yoyooxo/20261030_3D/card_reader_nicenano/讀卡機_整理.md

# 讀卡機（nice!nano＋健保卡卡座）整理

更新：2026-11-12

## 1. 目標

把老師麵包板上的讀卡機原型，原樣搬到洞洞板上，不用麵包板。

- 只用 **nice!nano v2（nRF52840）**，不用 BlackPill、DMC2038LVT、R1。
- 卡座貼在洞洞板背面，插卡口在上。
- nice!nano 的 USB-C 朝下，在插卡口對面。
- **線全部在正面，用 OK 線手焊。**
- 電池另外用雙面膠黏。

## 2. 手上的資料

| 資料 | 位置 | 內容 |
|---|---|---|
| 老師線路圖 | `老師給的東西\261103_nrf_card.pdf` | nice!nano 接 ISO 7816 卡座，接線照這份 |
| 卡座腳位（紅字） | 老師線路圖紙本的手寫標註（照片 742400 / 742404） | 插卡口那排 C5–C8、對面那排 C1–C4 |
| 卡座照片 | `S__13606916_0.jpg`、`S__13606917_0.jpg` | 卡座正反面 |
| 麵包板原型 | `742396.jpg`、`742400.jpg`、`742404.jpg` | 老師接好的原型 |
| 卡座焊在洞洞板 | `742616.jpg`、`S__14311426.jpg` | 8 支腳直接焊進洞洞板 |
| 裝盒成品 | `742949.jpg` | 3D 列印盒子裡的最終擺法 |
| 實測 | 你量的 | 卡座長邊 62 mm |

照片都在 `C:\Users\jkgen\Documents\實驗室資料夾\硬體\IC卡設計\老師給的東西\`。

## 3. 線路（照老師 261103_nrf_card.pdf）

| 卡座 J1 | 接到 nice!nano | 說明 |
|---|---|---|
| C1 VCC | VCC（腳 21） | +3V3_CARD，可用 P0.13 開關，所以可以斷電重開卡片 |
| C2 RST | P0.24（腳 8） | RST |
| C3 CLK | P0.17（腳 5） | CLK |
| C5 GND | GND（腳 3、4 併接） | 卡片 GND |
| C7 I/O | P0.20（腳 6）＋P0.22（腳 7） | 兩腳併接 |
| SW1 DET | P1.00（腳 9） | 插卡偵測（選配） |
| SW2 DET_G | GND | 偵測開關接地（選配） |
| C4、C6、C8 | 不接 | 腳還是焊進洞，用來固定卡座 |

其他：

- C10 0.1 µF：跨在 VCC 和 GND 之間。
- 電池＋：接 RAW（腳 24），電池－接 GND（腳 23）。
- P0.08 標「UART_TX」、P1.06 標「U3_D1」，另一端沒接東西，不焊。

## 4. 照片上確定的事

1. **卡座 8 支腳：** 分兩排，每排 4 支連在一起（間距 2.54 mm），直接焊進洞洞板。
2. **兩排間距：** 相隔 16 個孔，約 40 mm，所以卡座約 62 × 40 mm。
3. **洞洞板：** 老師用的約 12 × 22 孔（30.5 × 55.9 mm）。卡座左緣比板子多出約 4 mm。
4. **nice!nano：** 平貼在板子左下，USB-C 朝下，轉 180°。
   - 左排（c1，下→上）：RAW、GND、RST、VCC、P0.31…
   - 右排（c7，下→上）：P0.06、P0.08、GND、GND、P0.17、P0.20、P0.22、P0.24、P1.00…
5. **電池：** 在 nice!nano 右邊、卡座下方，約 13 × 23 mm。
6. **盒子：** 3D 列印、接近正方形、有蓋，下側開孔給 USB-C。
7. **燒錄排針：** 盒子裡有一個 3 pin 彎排針插在卡座上，應該是燒錄用。麵包板原型則是 6 pin（TX、RX、SWCLK、SWDIO、2.8V、GND）。

## 5. 目前的 Layout：v6

檔案：`讀卡機Layout_v6.png`（另有 `.svg`、`gen_layout_card6.py`）

### 擺法

- **洞洞板：** 12 × 22 孔（30.5 × 55.9 mm），直放，上緣對齊插卡口。
- **卡座：** 在板子背面。
- **卡座 8 個洞：**

| 位置 | c9 | c10 | c11 | c12 |
|---|---|---|---|---|
| 插卡口那排（第 22 列） | C8 | C7 | C6 | C5 |
| 對面那排（第 6 列） | C4 | C3 | C2 | C1 |

- **nice!nano：** 腳在 c1、c7，第 1–12 列，USB-C 從板子下緣凸出。
- **C10：** c11、c12 第 4 列。
- **電池：** 在 nice!nano 右邊下方（c8–c13、第 1–5 列），最後用雙面膠黏。
- **J2：** 燒錄 3 pin，位置先畫在板子右邊的卡座上，還沒接線。

### 接線表（全部在正面，OK 線）

| 線 | 從 | 到 | 用途 |
|---|---|---|---|
| K1 | VCC 腳21 (c1,r4) | J1 C1 VCC (c12,r6) | +3V3_CARD，經過 C10 |
| K2 | GND 腳4 (c7,r4) | J1 C5 GND (c12,r22) | 卡片 GND，跨過 nice!nano |
| K3 | P0.24 腳8 (c7,r8) | J1 C2 RST (c11,r6) | RST |
| K4 | P0.17 腳5 (c7,r5) | J1 C3 CLK (c10,r6) | CLK |
| K5 | P0.20 腳6 (c7,r6) | J1 C7 I/O (c10,r22) | I/O，跨過 nice!nano |
| K6 | P0.20 腳6 (c7,r6) | P0.22 腳7 (c7,r7) | I/O 兩腳併接 |
| K7 | GND 腳3 (c7,r3) | GND 腳4 (c7,r4) | GND 兩腳併接 |
| K10 | GND 腳4 (c7,r4) | C10 左腳 (c11,r4) | C10 接地 |
| K8 | P1.00 腳9 (c7,r9) | J1 SW1 DET | 插卡偵測（選配） |
| K9 | J1 SW2 DET_G | C10 左腳 GND (c11,r4) | 偵測開關接地（選配） |
| K11 | 電池 ＋ | RAW 腳24 (c1,r1) | VBAT |
| K12 | 電池 － | GND 腳23 (c1,r2) | 電池負極 |

孔位寫法：(c 欄, r 列)。c 從左到右 1–12，r 從下到上 1–22，正面俯視。

- K2、K5 會從 nice!nano 上方跨過；K1 會跨過 K4；K9 會跨過 K1。
- OK 線有絕緣，交叉沒關係。

### 組裝順序

1. 卡座 8 支腳焊進洞，nice!nano 固定好（背面剪平）。
2. 正面用 OK 線照接線表接。
3. 最後貼電池。

## 6. 還沒確定、要確認的

| 項目 | 目前做法 | 怎麼確認 |
|---|---|---|
| 插卡口在哪一排 | 照你說的放上面 | 實際插卡看一下 |
| 卡座寬度、腳的確切位置 | 照片估約 40 mm、兩排相隔 16 孔 | 用尺量卡座和兩排腳的距離 |
| 偵測開關 SW1/SW2 的腳在哪 | 先畫在板子右外側 | 看卡座實物 |
| J2 燒錄 3 pin 各接哪裡 | 先不接 | 問老師，或看盒裡那片板子的線 |
| 電池實際大小 | 約 13 × 23 mm（照片估） | 量電池 |
| 盒子內部尺寸 | 沒畫 | 量盒子，或跟老師要列印檔 |

## 7. Layout 版本紀錄

| 版本 | 檔案 | 重點 |
|---|---|---|
| v1 | `讀卡機Layout_v1.png` | 25 × 61 直放，nice!nano 在下；左右排 C 接點是假設的（之後證實相反） |
| demo v2 | `讀卡機Layout_demo_v2.png` | 板子橫放 |
| demo v3 | `讀卡機Layout_demo_v3.png` | 直放靠卡座右緣，USB-C 在插卡口對面 |
| v4 | `讀卡機Layout_v4.png` | 卡座 8 支腳都插洞，板子加寬到 13 欄 |
| v5 | `讀卡機Layout_v5.png` | 照老師盒裝版排法；兩排腳間距估成 13 孔（估錯） |
| **v6** | `讀卡機Layout_v6.png` | **目前版本**：照片重新數孔，12 × 22 孔、兩排腳相隔 16 孔 |

## 8. 跟 GitHub 的關係

- GitHub（`yoyooxo/20261030_3D`）目前是上一個專案的內容：61 × 53 洞洞板＋BlackPill＋DMC2038LVT，以及線路圖和舊 PCB。
- 讀卡機這套（`讀卡機_nicenano` 資料夾）**還沒推上 GitHub**。
