yoyooxo/20261030_3D/card_reader_nicenano/讀卡機Layout_v5.png

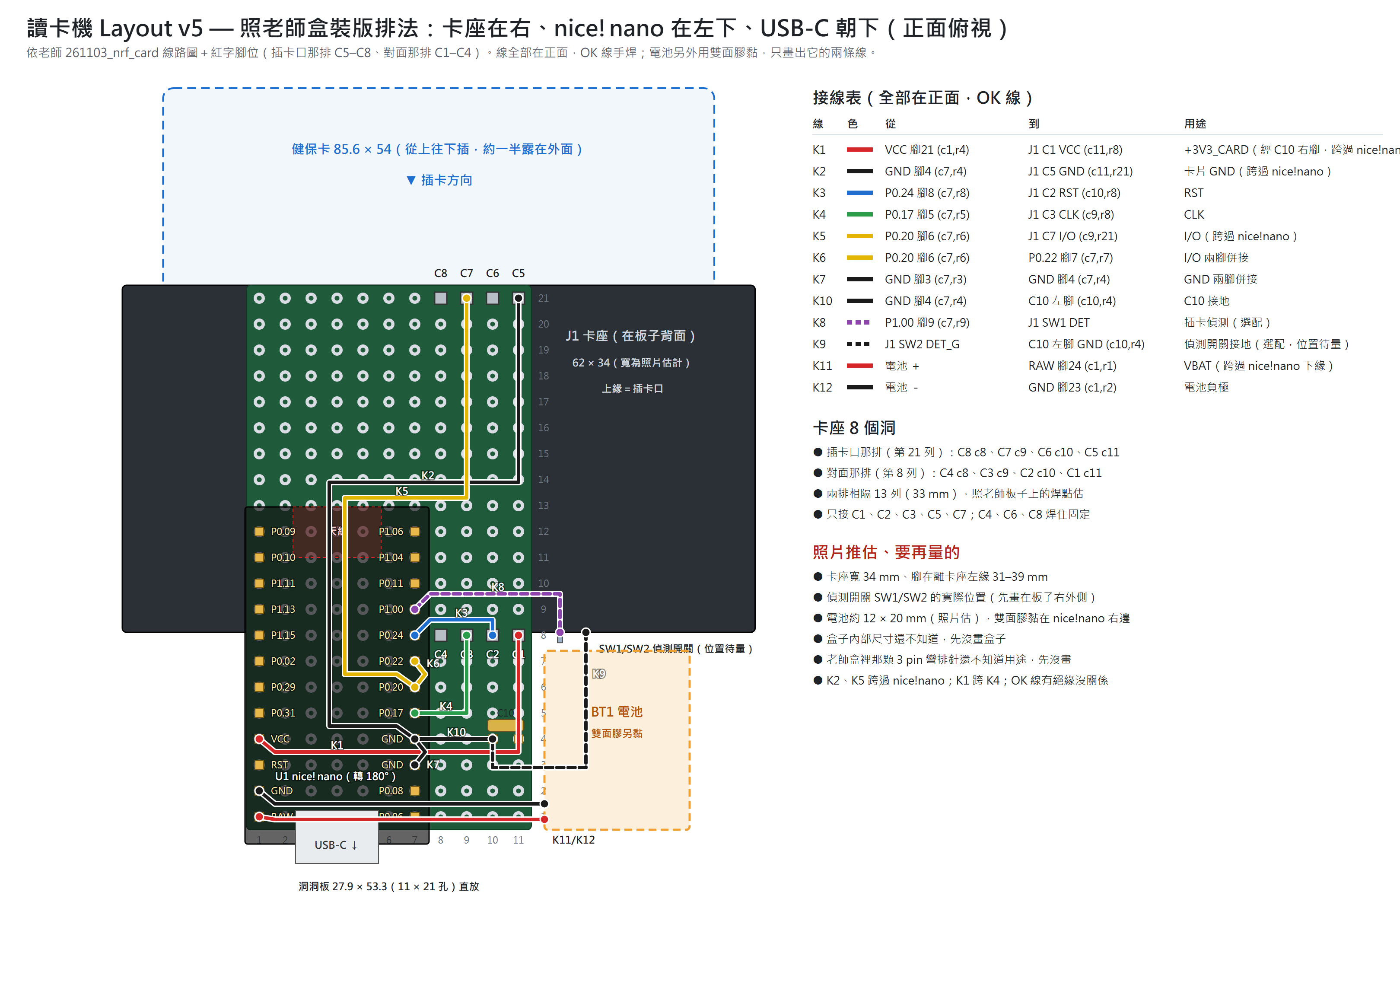
card_reader_nicenano/讀卡機Layout_v5.png
