yoyooxo/20261030_3D/pcb_flat/3d_side.png

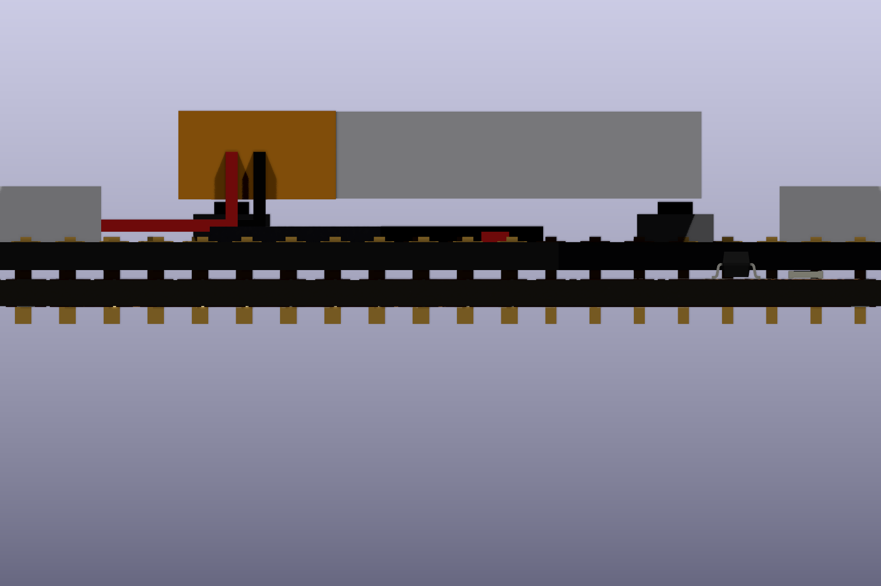
pcb_flat/3d_side.png
