yoyooxo/20261030_3D/pcb_flat/3d_top_iso.png

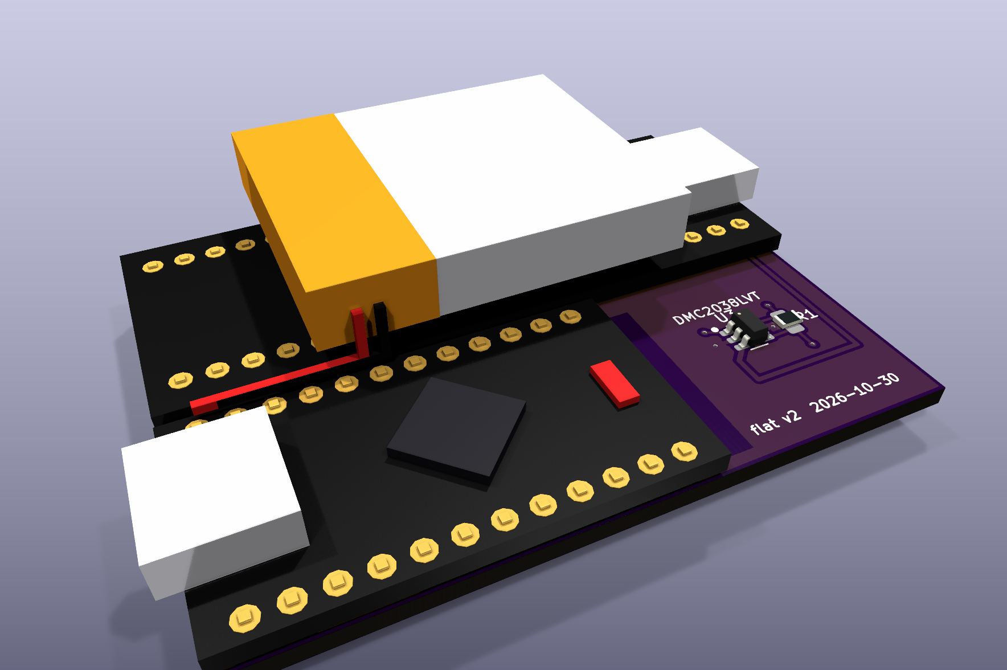
pcb_flat/3d_top_iso.png
