yoyooxo/20261030_3D/pcb_flat/dimensions.png

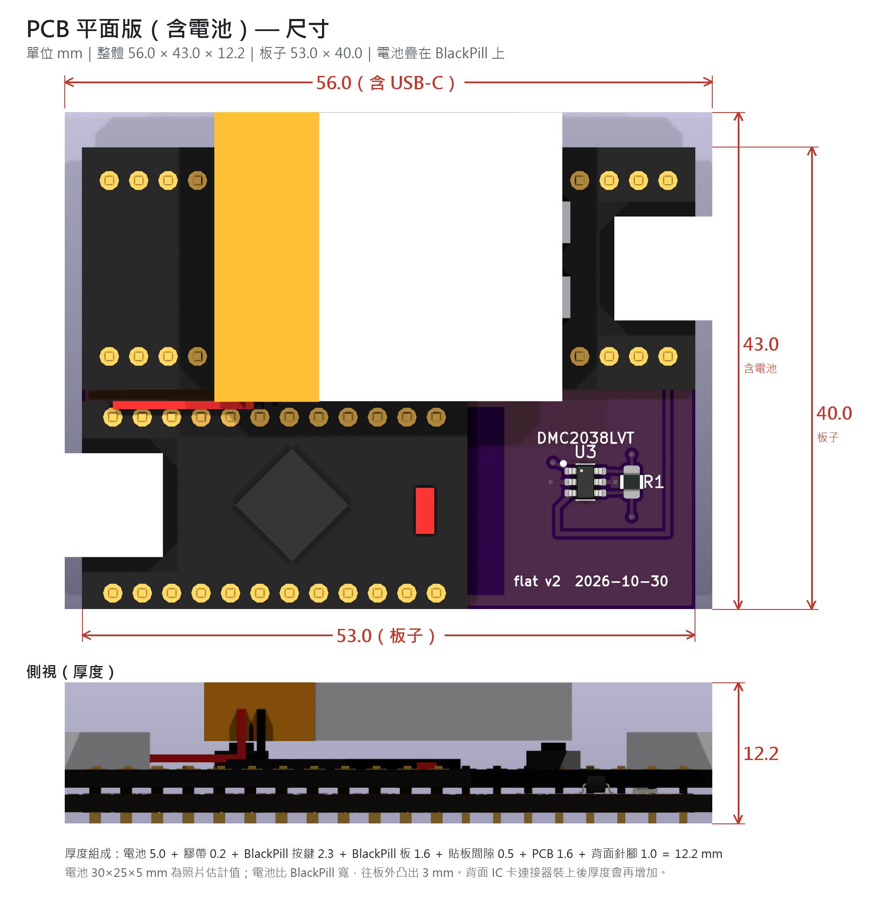
pcb_flat/dimensions.png
