yoyooxo/20261030_3D/pcb_flat/front_back.png

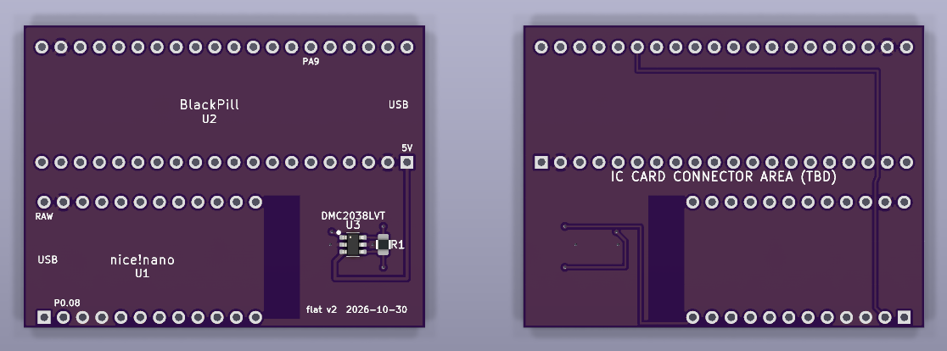
pcb_flat/front_back.png
