yoyooxo/20261030_3D/perfboard/perfboard_layout_61x53.png

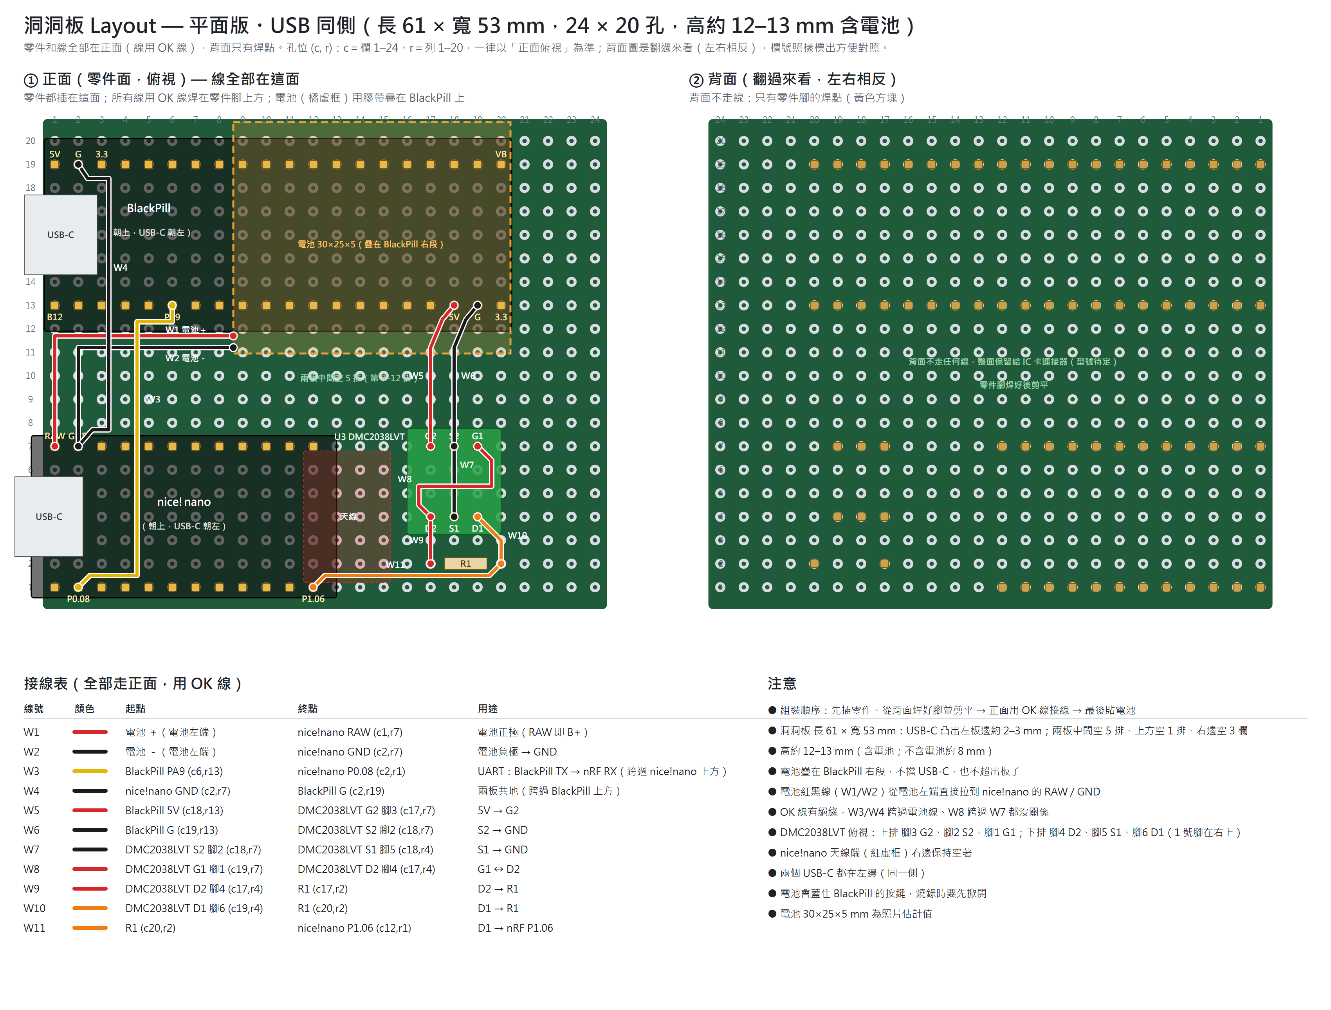
perfboard/perfboard_layout_61x53.png
