yoyooxo/20261030_3D/schematic/schematic_61x53.png

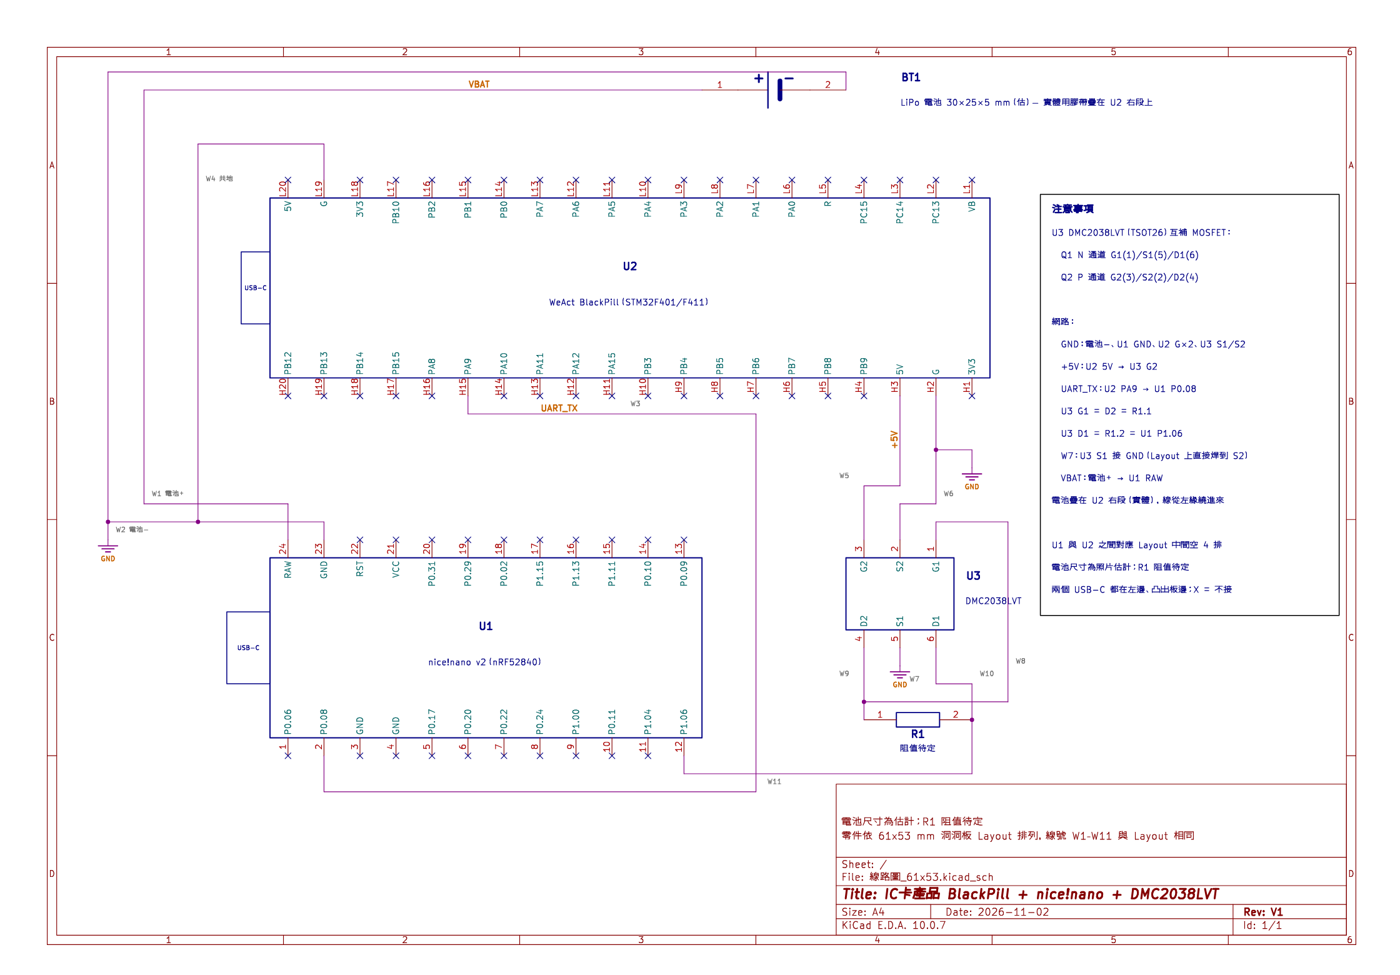
schematic/schematic_61x53.png
