yoyooxo/20261030_3D/schematic/schematic_61x53.pdf

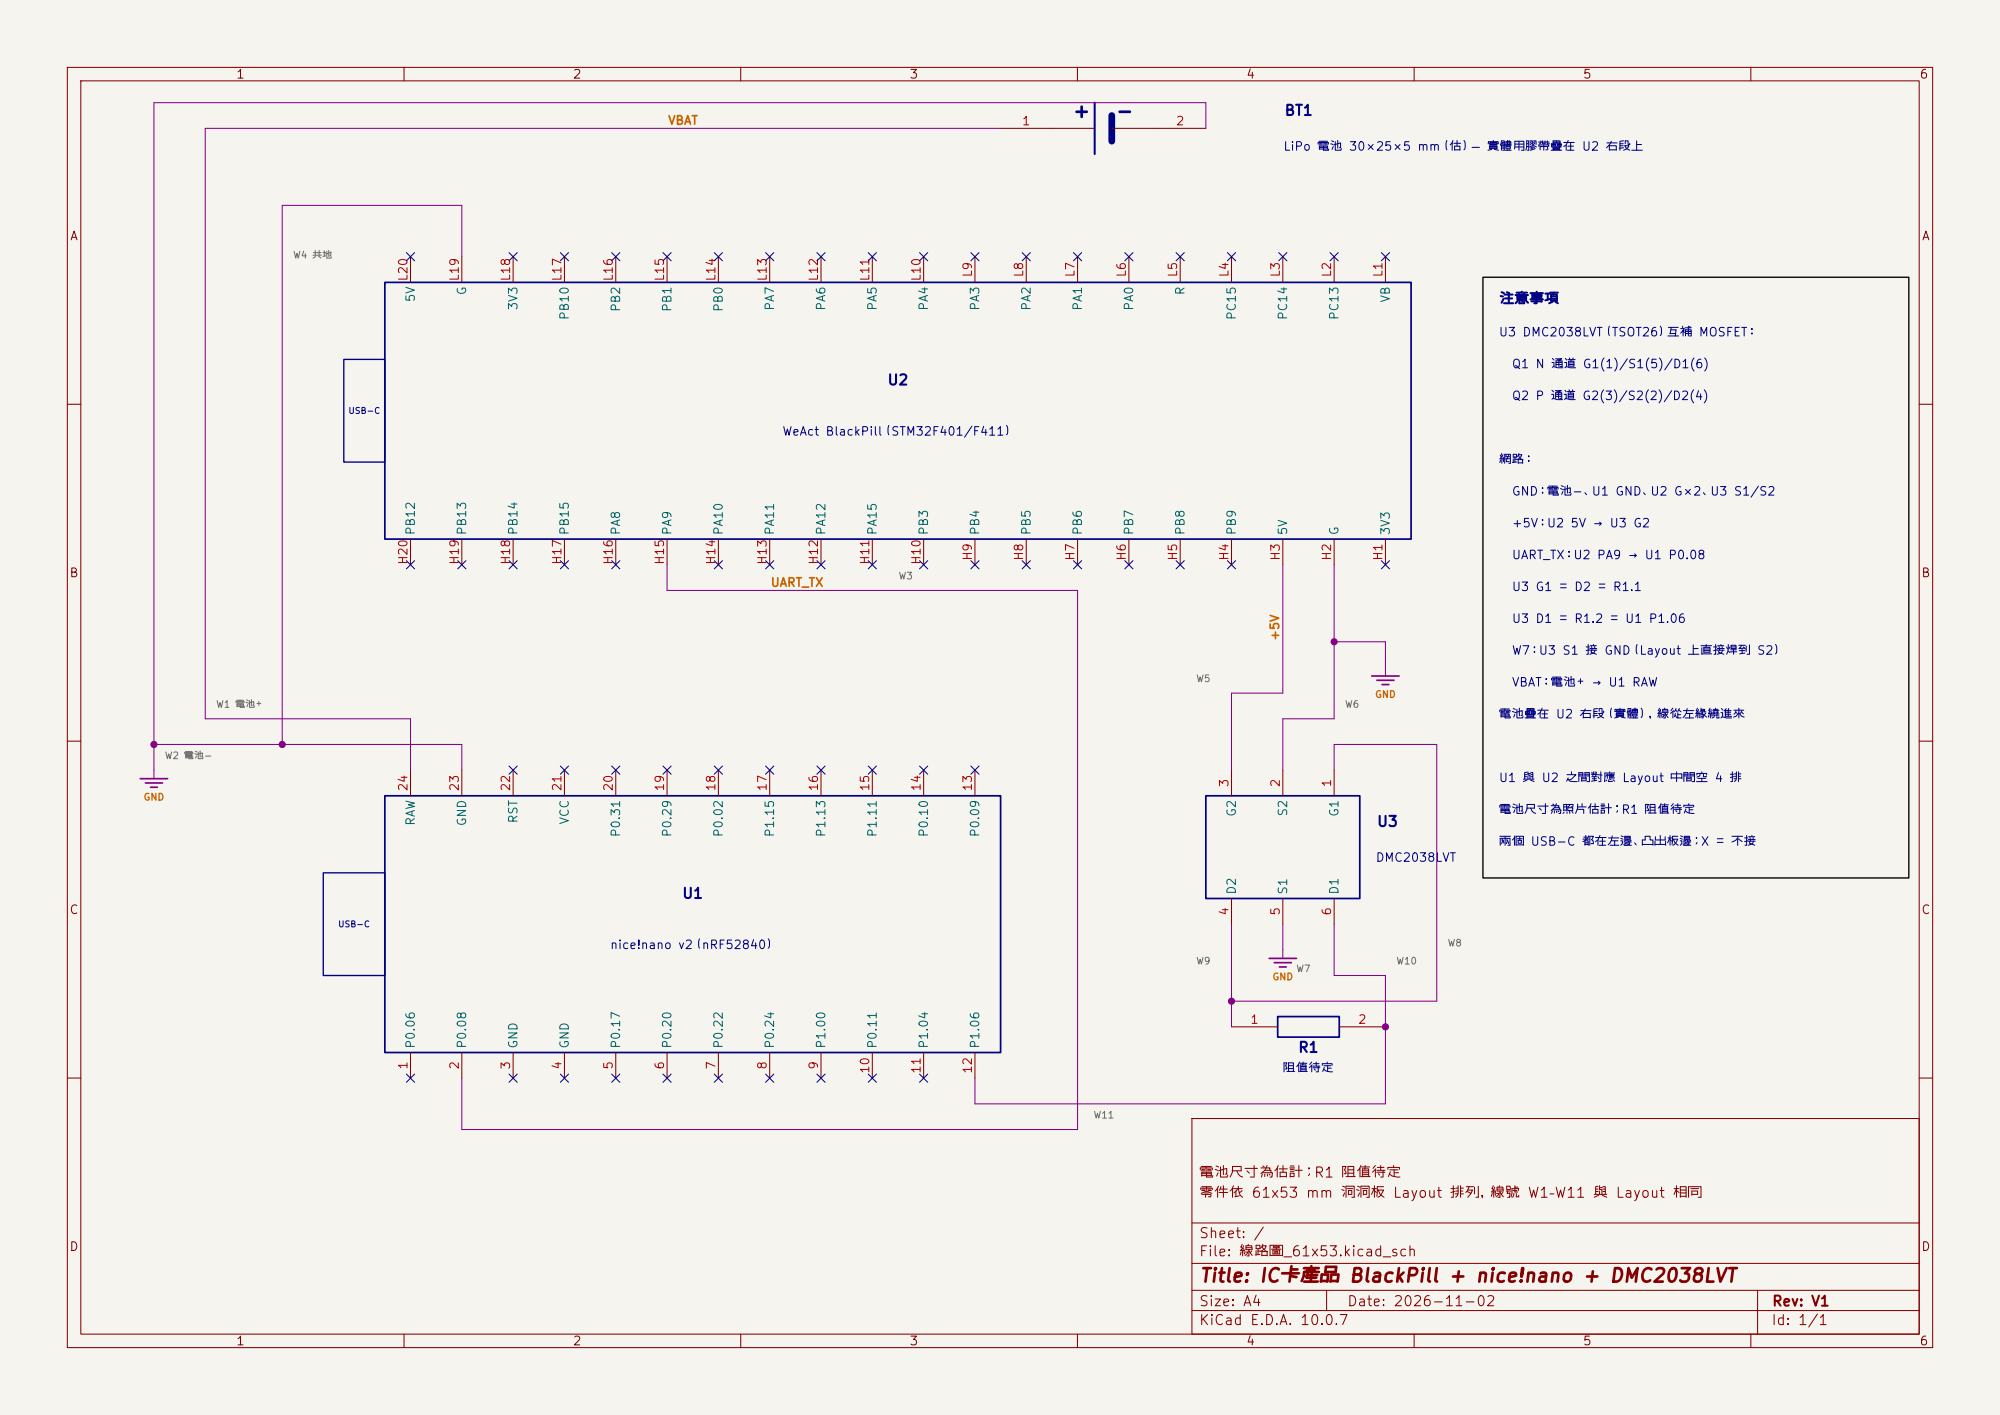
[picture p13: page 1]

LiPo 電池 30×25×5 mm（估）— 實體用膠帶疊在 U2 右段上 G1

GND：電池−、U1 GND、U2 G×2、U3 S1/S2 兩個 USB-C 都在左邊、凸出板邊；X ＝ 不接

VBAT：電池＋ → U1 RAW 電池疊在 U2 右段（實體），線從左緣繞進來

9 P0.11 10 P1.04 11 P1.06 12 P0.09 13 P0.10 14 P1.11 15 P1.13 16 P1.15 17 P0.02 18 P0.29 19 P0.31 20 VCC 21 RST 22 GND 23 RAW 24

電池尺寸為估計；R1 阻值待定
零件依 61x53 mm 洞洞板 Layout 排列，線號 W1–W11 與 Layout 相同

Sheet: /
File: 線路圖_61x53.kicad_sch
Title: IC卡產品 BlackPill + nice!nano + DMC2038LVT

Size: A4 | Rev: V1
KiCad E.D.A. 10.0.7 | Id: 1/1
