yoyooxo/20261030_3D/pcb_flat/front_back_view.kicad_pcb

## KiCad design pcb_flat/front_back_view.kicad_pcb (2026-10-31)

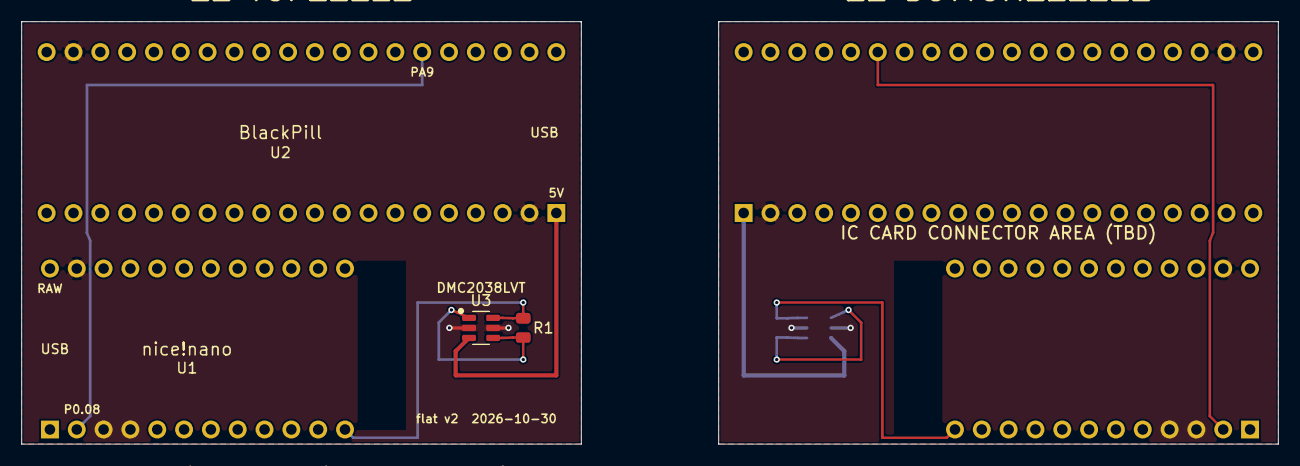
[picture p14: board front_back_view.kicad_pcb from above]

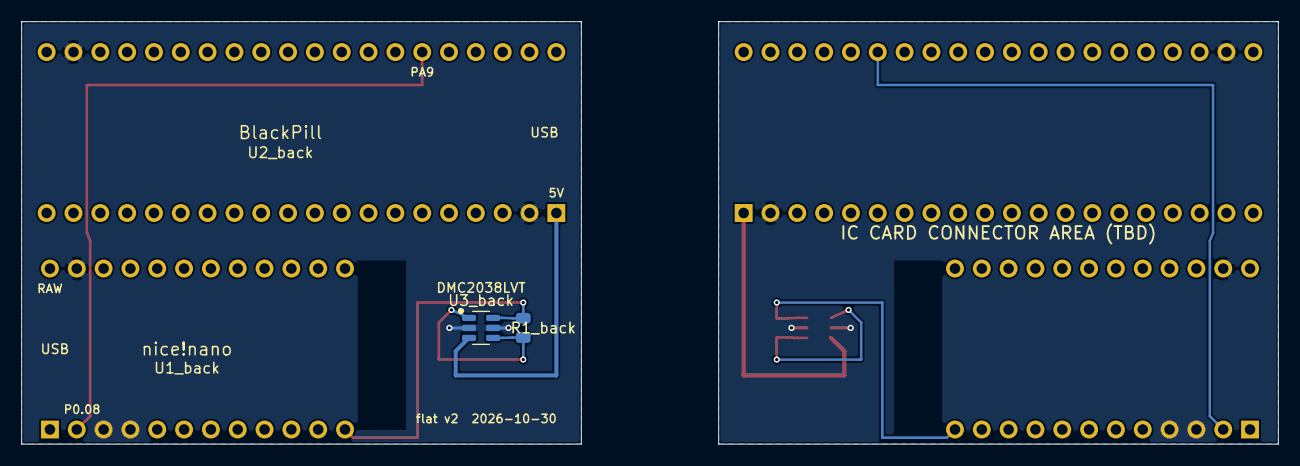
[picture p15: board front_back_view.kicad_pcb from below]

Board: 2 copper layers, 119.0 x 40.0 mm, 10 parts (5 on the bottom side), 5 nets.

Parts:
BT1, BT1_back: LiPo_30x25x5_on_BlackPill
R1, R1_back: R_0805
U1, U1_back: nice!nano_v2
U2, U2_back: WeAct_BlackPill
U3, U3_back: DMC2038LVT_SOT-23-6

Connections:
+5V: U2.L1, U2_back.L1, U3.3, U3_back.3
GND: U1.3, U1.4, U1.23, U1_back.3, U1_back.4, U1_back.23, U2.H19, U2.L2, U2_back.H19, U2_back.L2, U3.2, U3.5, U3_back.2, U3_back.5
N_D1: R1.2, R1_back.2, U1.12, U1_back.12, U3.6, U3_back.6
N_G1_D2: R1.1, R1_back.1, U3.1, U3.4, U3_back.1, U3_back.4
UART_PA9_P0.08: U1.2, U1_back.2, U2.H6, U2_back.H6
