yoyooxo/20261030_3D/pcb_flat/flat_pcb.kicad_pcb

## KiCad design pcb_flat/flat_pcb.kicad_pcb (2026-10-31)

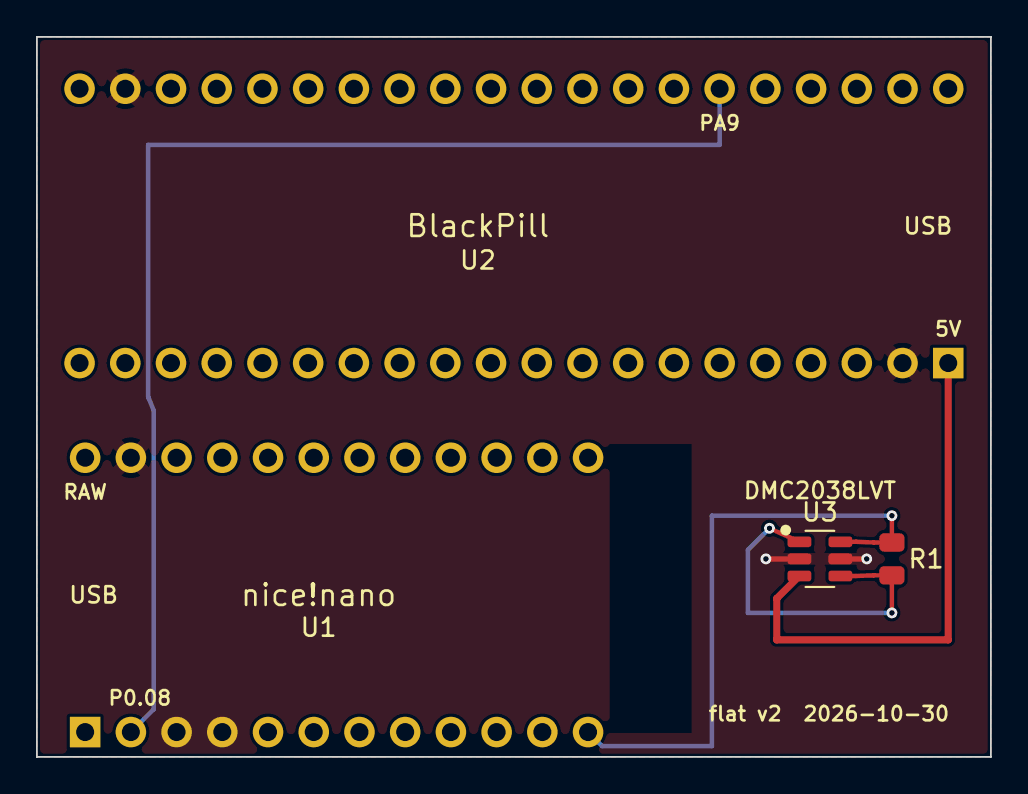
[picture p16: board flat_pcb.kicad_pcb from above]

Board: 2 copper layers, 53.0 x 40.0 mm, 5 parts (0 on the bottom side), 5 nets.

Parts:
BT1: LiPo_30x25x5_on_BlackPill
R1: R_0805
U1: nice!nano_v2
U2: WeAct_BlackPill
U3: DMC2038LVT_SOT-23-6

Connections:
+5V: U2.L1, U3.3
GND: U1.3, U1.4, U1.23, U2.H19, U2.L2, U3.2, U3.5
N_D1: R1.2, U1.12, U3.6
N_G1_D2: R1.1, U3.1, U3.4
UART_PA9_P0.08: U1.2, U2.H6
