yoyooxo/20261030_3D/(commit log)

2026-10-30 Add 3D model of the breadboard build (second round)
    - VRML model and KiCad carrier board (open with Alt+3 to rotate)
    - Overview render with component labels and U3 close-up
    - README describing files and annotations
    [breadboard_3d.kicad_pcb]
2026-10-30 README: name U3 as 3.3V LDO and describe the headers
2026-10-30 README: embed 3D renders and use ASCII image names
    [breadboard_restore.kicad_sch]
2026-10-30 Correct wiring from annotated photos and identify U3 as DMC2038LVT
    - Green GND wire lands on column 28 lower; add 27-top to 29-bottom link
    - Fix long yellow P0.06 wire that never rendered (tube frame collapse)
    - Purple wire no longer hidden under the red one
    - Relabel U3 as DMC2038LVT complementary MOSFET in all figures and README
    [breadboard_3d.kicad_pcb, breadboard_restore.kicad_sch]
2026-10-30 Add perfboard product layouts: flat (side-by-side) and stacked (minimal)
    [perfboard_product.kicad_pcb, perfboard_product_nobattery.kicad_pcb, perfboard_v1.kicad_pcb, perfboard_v1_no_blackpill.kicad_pcb, perfboard_v1_no_bottom.kicad_pcb]
2026-10-30 Add view-only PCB with front and flipped back side by side
    [pcb_front_back_side_by_side.kicad_pcb]
2026-10-30 README: reorganize into steps with overview, circuit tables and image grids
2026-10-30 README: refer to the MOSFET as DMC2038LVT instead of U3
2026-10-31 Add flat-layout PCB and make it the README focus
    [flat_pcb.kicad_pcb, front_back_view.kicad_pcb]
2026-10-31 Remove old breadboard, 3D, perfboard and stacked-PCB files
    [breadboard_3d.kicad_pcb, breadboard_restore.kicad_sch, pcb_front_back_side_by_side.kicad_pcb, perfboard_product.kicad_pcb, perfboard_product_nobattery.kicad_pcb, perfboard_v1.kicad_pcb, perfboard_v1_no_blackpill.kicad_pcb, perfboard_v1_no_bottom.kicad_pcb]
2026-10-31 Add dimension drawing (size and thickness) to flat PCB README
2026-10-31 Stack battery on BlackPill (option B), update dimensions to 56 x 43 x 12.2
    [flat_pcb.kicad_pcb, front_back_view.kicad_pcb]
2026-11-02 Add 62 x 62 mm perfboard layout (both USB-C on the left)
2026-11-02 README: describe the 62 x 62 mm perfboard version
2026-11-02 Replace 62x62 perfboard with 61x53 layout (front-side wiring) and add schematic
    - 61 x 53 mm perfboard, both USB-C protruding on the left, 5-row gap between boards
    - All wires on the front (OK wire); back kept clear for the IC card connector
    - DMC2038LVT drawn in true top view (pin 1 top-right), wiring updated
    - KiCad schematic arranged like the layout
    [schematic_61x53.kicad_sch]
2026-11-12 Add nRF52840 card reader perfboard layouts (v1-v7)
    Single-module NHI card reader on perfboard: layout drawings, generator
    scripts and notes. v7 is the current layout, recounted from the build
    photos (11 x 24 holes, socket legs in c8-c11 at rows 24 and 8).
